spark2k06/XTSD/README.md

XTSD (Low Profile)  ReadMe
--------------------------

8-bit ISA IDE interface with IDE female connector for SD Adapter + Boot ROM (two separate functions that can be used individually).

Credit:
-------

Design uses schematic from Monotech-PC, which, in turn, is based on the schematic from XT-IDE Rev2 and Glitchworks:

https://github.com/monotech/XT-IDE-Deluxe
http://www.github.com/glitchwrks/xt_ide

XT-IDE Universal BIOS\
www.xtideuniversalbios.org  
www.xtideuniversalbios.org/binaries  

Use the latest working binary that includes XTIDECFG.COM (config utility), ide_xt.bin (8086/8088), ide_xtp.bin (80186/V20/V30 and up).

More info:

https://www.tindie.com/products/spark2k06/micro-xtcf-isa-8-bits-very-low-profile/
