spark2k06/XTSD/Schema.pdf

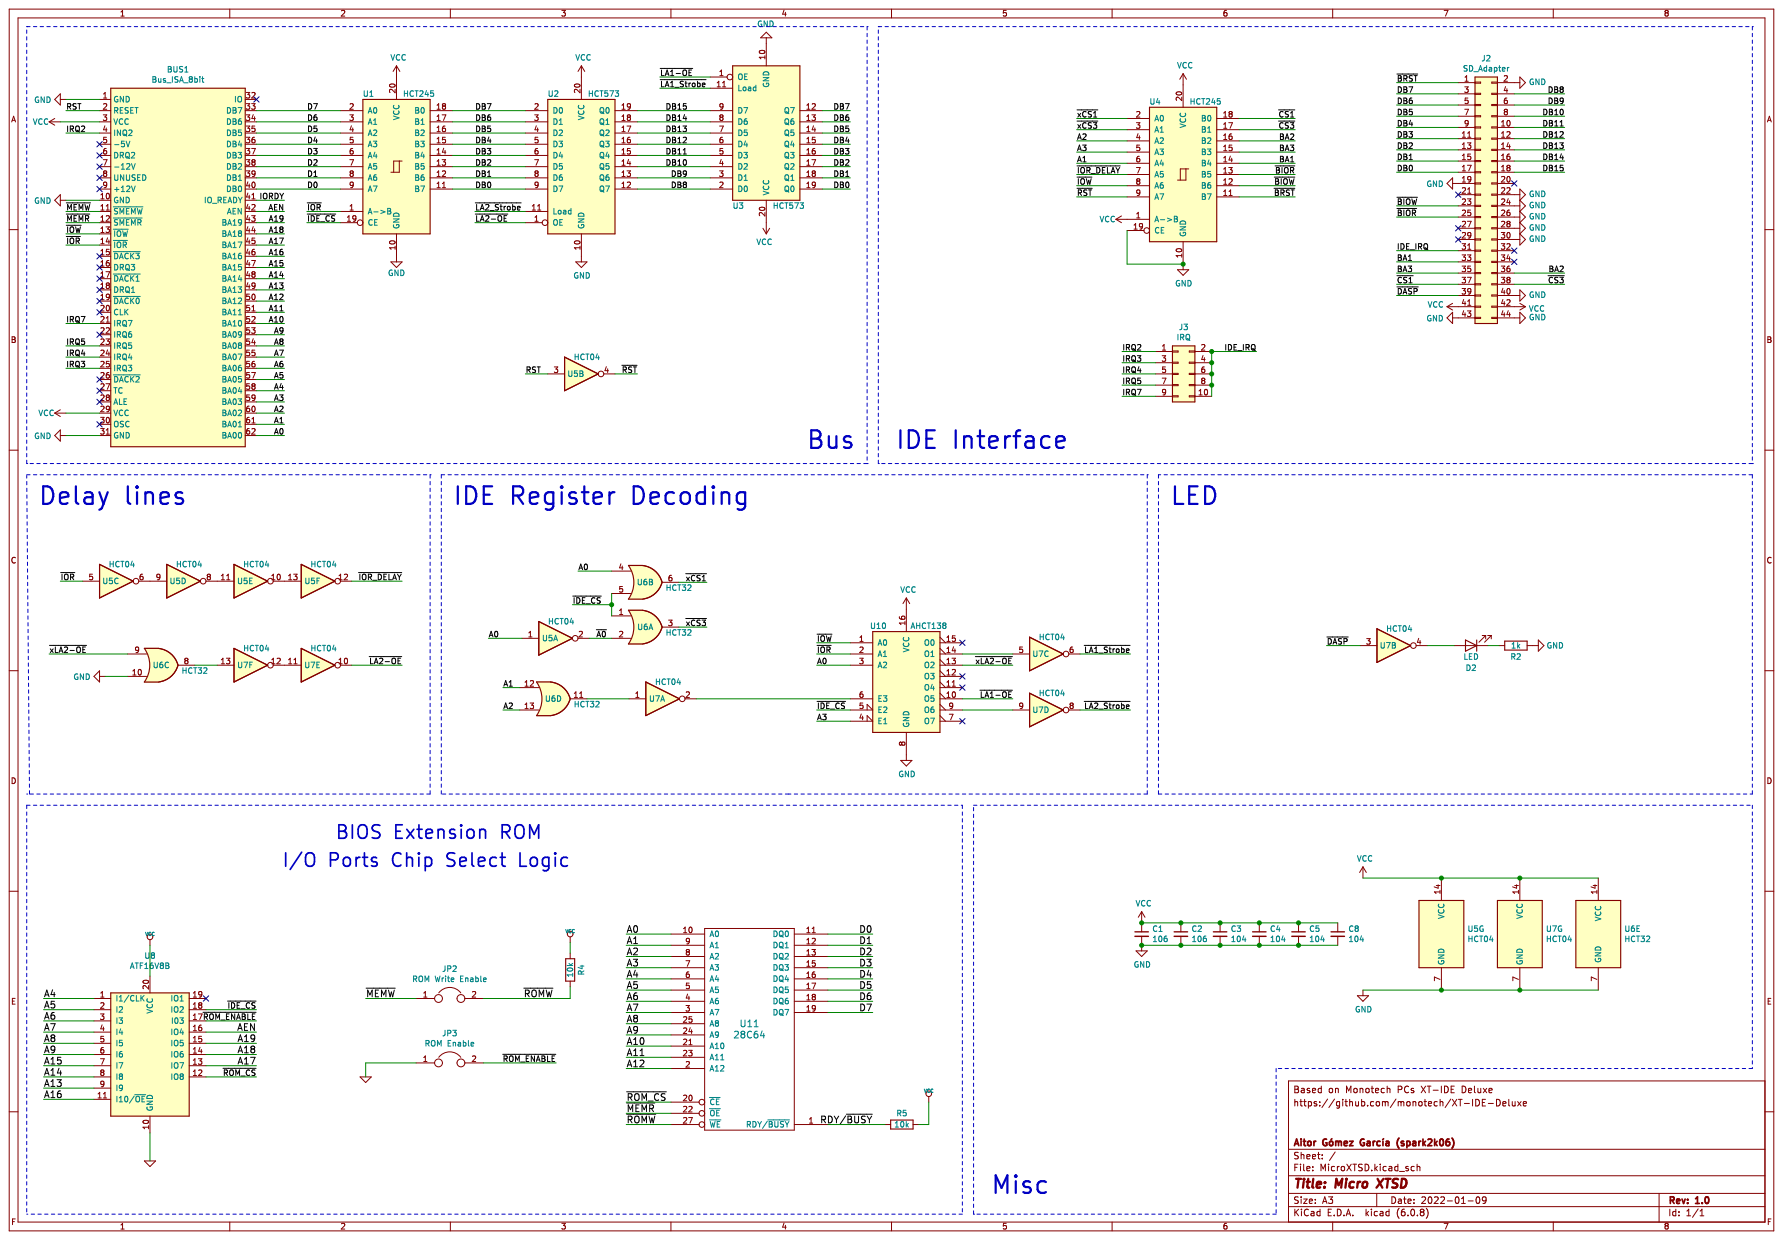
[picture p1: page 1]
