spark2k06/XTSD/kicad/MicroXTSD.kicad_sch

## KiCad design kicad/MicroXTSD.kicad_sch (2023-02-01)

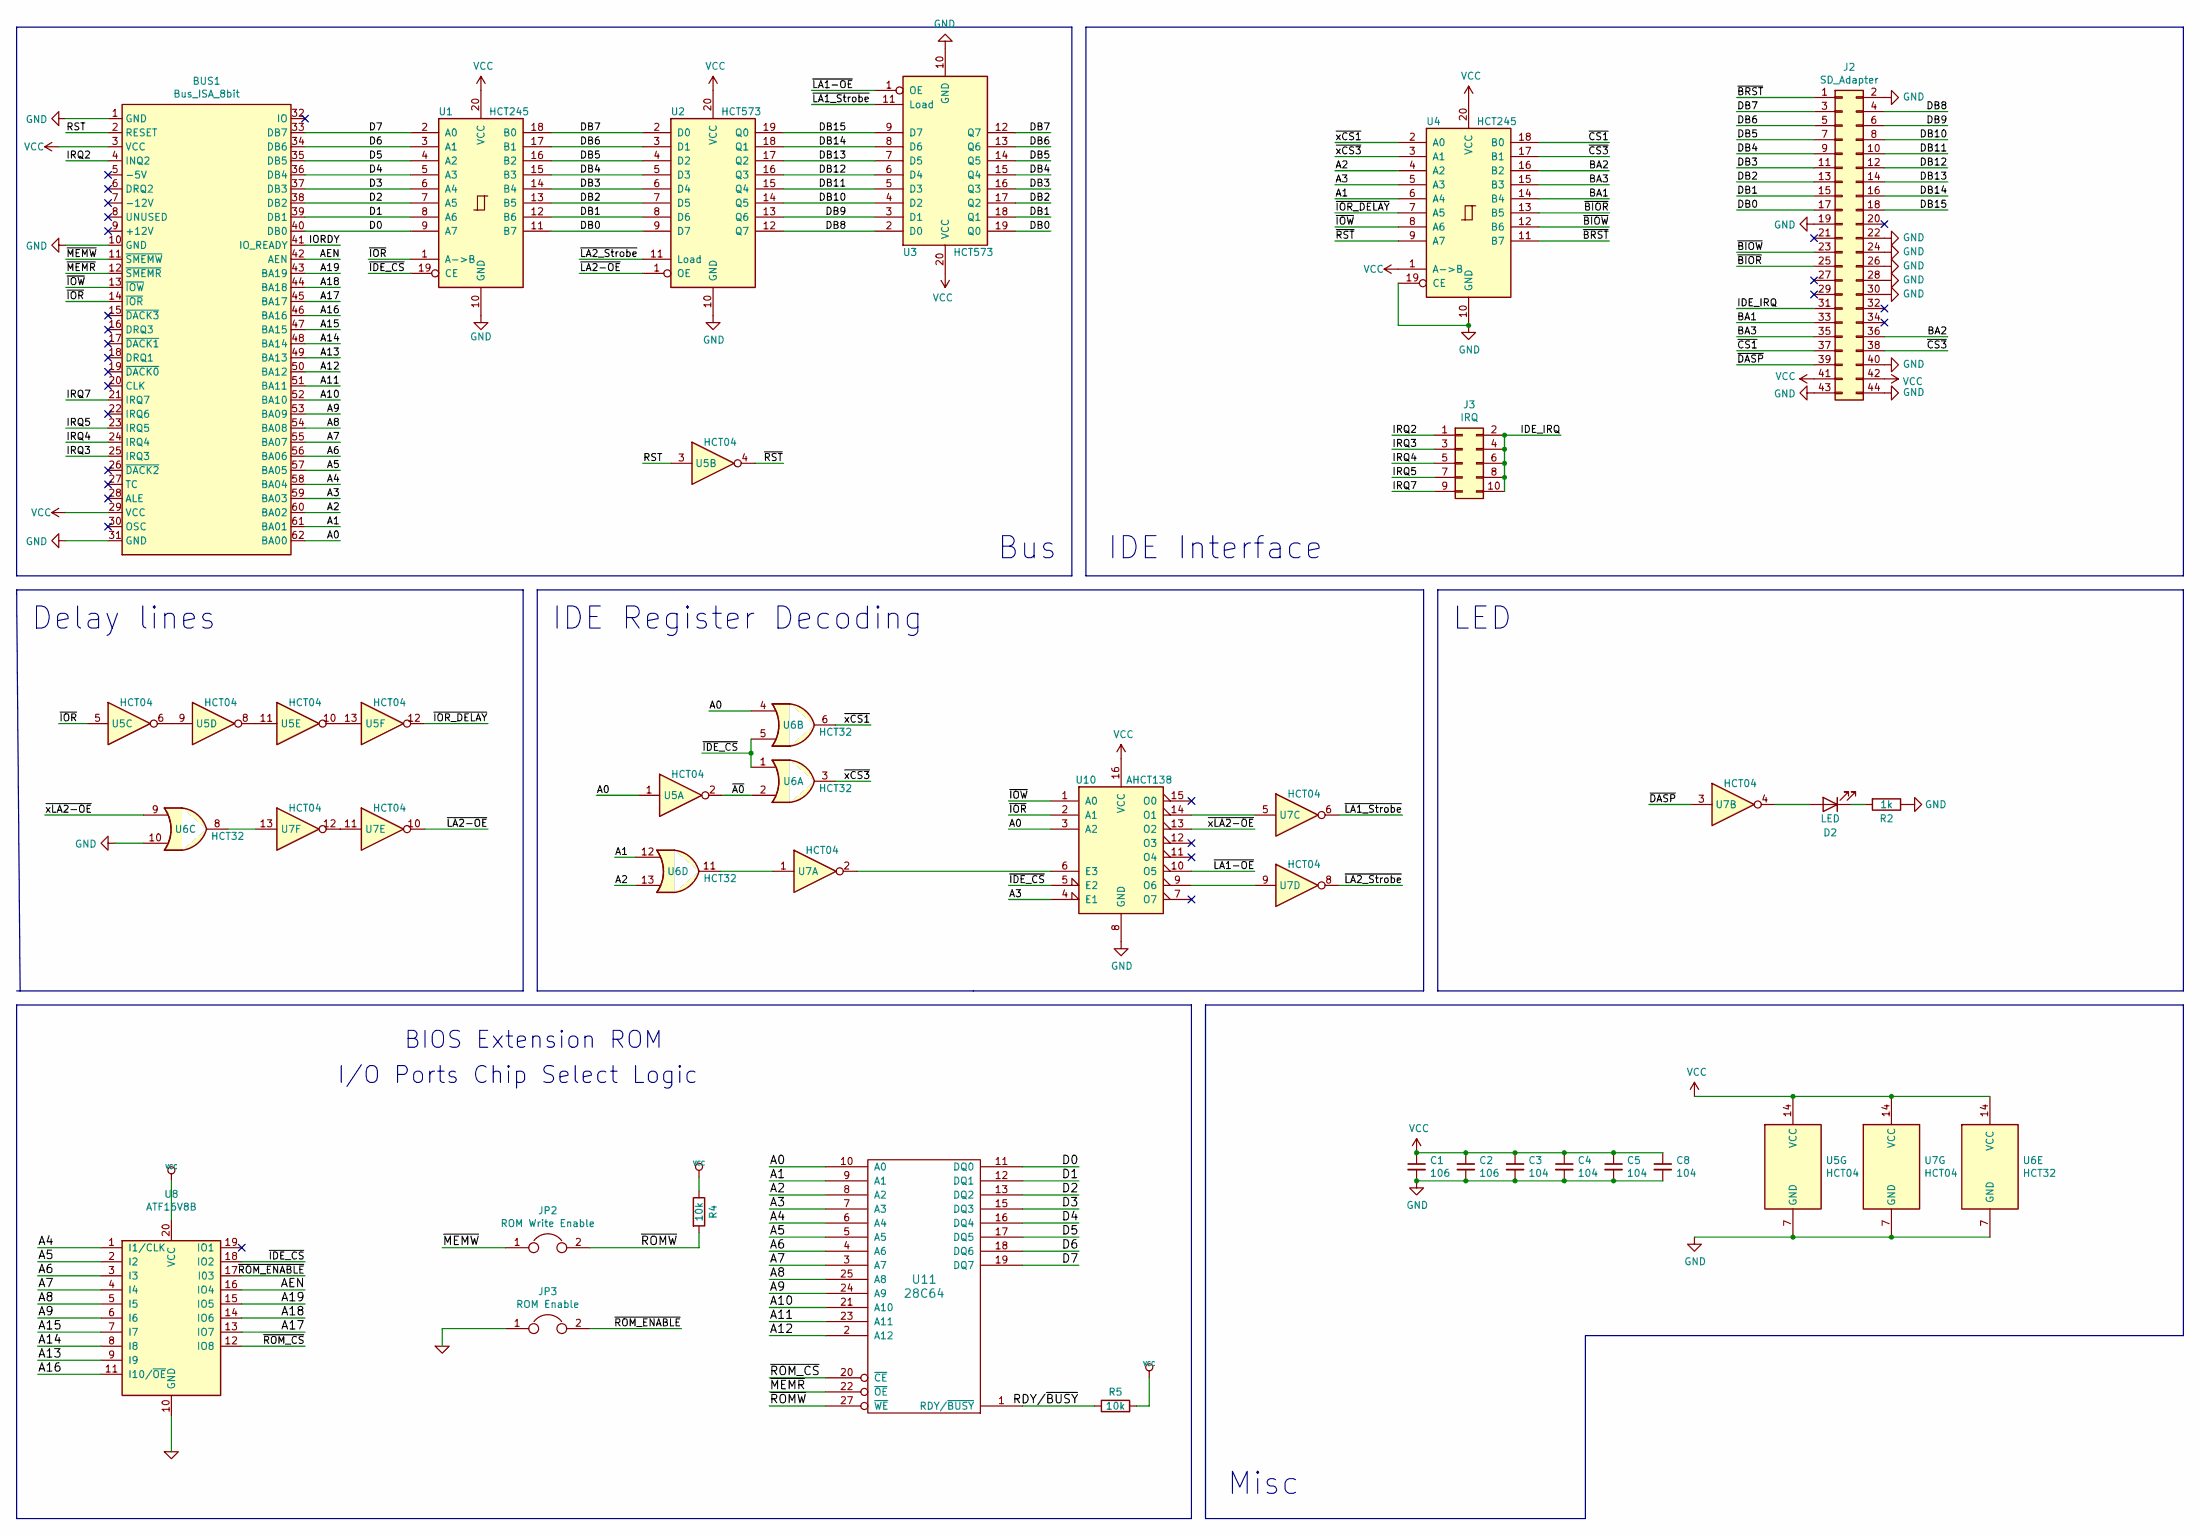
[picture p2: schematic MicroXTSD.kicad_sch]

Parts:
BUS1: Bus_ISA_8bit; ISA-8BIT-XT-IDE
C1, C2: 106; C_0805_2012Metric
C3, C4, C5, C8: 104; C_0805_2012Metric
D2: LED; PinHeader_1x02_P2.54mm_Horizontal
J2: SD_Adapter; PinSocket_2x22_P2.00mm_Horizontal
J3: IRQ; PinHeader_2x05_P2.54mm_Vertical
JP2: ROM Write Enable; PinHeader_1x02_P2.54mm_Vertical
JP3: ROM Enable; PinHeader_1x02_P2.54mm_Vertical
R2: 1k; R_0805_2012Metric
R4, R5: 10k; R_0805_2012Metric
U1, U4: HCT245; TSSOP-20_4.4x6.5mm_P0.65mm
U2, U3: HCT573; SO-20_5.3x12.6mm_P1.27mm
U5, U7: HCT04; SOIC-14_3.9x8.7mm_P1.27mm
U6: HCT32; SOIC-14_3.9x8.7mm_P1.27mm
U8: ATF16V8B; DIP-20_W7.62mm_Socket
U10: AHCT138; SOIC-16_3.9x9.9mm_P1.27mm
U11: 28C64; DIP-28_W15.24mm_Socket

Connections:
A0: BUS1.62 (BA00), U5.1, U6.4, U10.3 (A2), U11.10 (A0)
A1: BUS1.61 (BA01), U4.6 (A4), U6.12, U11.9 (A1)
A2: BUS1.60 (BA02), U4.4 (A2), U6.13, U11.8 (A2)
A3: BUS1.59 (BA03), U4.5 (A3), U10.4 (E1), U11.7 (A3)
A4: BUS1.58 (BA04), U8.1 (I1/CLK), U11.6 (A4)
A5: BUS1.57 (BA05), U8.2 (I2), U11.5 (A5)
A6: BUS1.56 (BA06), U8.3 (I3), U11.4 (A6)
A7: BUS1.55 (BA07), U8.4 (I4), U11.3 (A7)
A8: BUS1.54 (BA08), U8.5 (I5), U11.25 (A8)
A9: BUS1.53 (BA09), U8.6 (I6), U11.24 (A9)
A10: BUS1.52 (BA10), U11.21 (A10)
A11: BUS1.51 (BA11), U11.23 (A11)
A12: BUS1.50 (BA12), U11.2 (A12)
A13: BUS1.49 (BA13), U8.9 (I9)
A14: BUS1.48 (BA14), U8.8 (I8)
A15: BUS1.47 (BA15), U8.7 (I7)
A16: BUS1.46 (BA16), U8.11 (I10/~OE)
A17: BUS1.45 (BA17), U8.13 (IO7)
A18: BUS1.44 (BA18), U8.14 (IO6)
A19: BUS1.43 (BA19), U8.15 (IO5)
AEN: BUS1.42 (AEN), U8.16 (IO4)
BA1: J2.33, U4.14 (B4)
BA2: J2.36, U4.16 (B2)
BA3: J2.35, U4.15 (B3)
D0: BUS1.40 (DB0), U1.9 (A7), U11.11 (DQ0)
D1: BUS1.39 (DB1), U1.8 (A6), U11.12 (DQ1)
D2: BUS1.38 (DB2), U1.7 (A5), U11.13 (DQ2)
D3: BUS1.37 (DB3), U1.6 (A4), U11.15 (DQ3)
D4: BUS1.36 (DB4), U1.5 (A3), U11.16 (DQ4)
D5: BUS1.35 (DB5), U1.4 (A2), U11.17 (DQ5)
D6: BUS1.34 (DB6), U1.3 (A1), U11.18 (DQ6)
D7: BUS1.33 (DB7), U1.2 (A0), U11.19 (DQ7)
DB0: J2.17, U1.11 (B7), U2.9 (D7), U3.19 (Q0)
DB1: J2.15, U1.12 (B6), U2.8 (D6), U3.18 (Q1)
DB2: J2.13, U1.13 (B5), U2.7 (D5), U3.17 (Q2)
DB3: J2.11, U1.14 (B4), U2.6 (D4), U3.16 (Q3)
DB4: J2.9, U1.15 (B3), U2.5 (D3), U3.15 (Q4)
DB5: J2.7, U1.16 (B2), U2.4 (D2), U3.14 (Q5)
DB6: J2.5, U1.17 (B1), U2.3 (D1), U3.13 (Q6)
DB7: J2.3, U1.18 (B0), U2.2 (D0), U3.12 (Q7)
DB8: J2.4, U2.12 (Q7), U3.2 (D0)
DB9: J2.6, U2.13 (Q6), U3.3 (D1)
DB10: J2.8, U2.14 (Q5), U3.4 (D2)
DB11: J2.10, U2.15 (Q4), U3.5 (D3)
DB12: J2.12, U2.16 (Q3), U3.6 (D4)
DB13: J2.14, U2.17 (Q2), U3.7 (D5)
DB14: J2.16, U2.18 (Q1), U3.8 (D6)
DB15: J2.18, U2.19 (Q0), U3.9 (D7)
GND: BUS1.1 (GND), BUS1.10 (GND), BUS1.31 (GND), C1.2, C2.2, C3.2, C4.2, C5.2, C8.2, J2.2, J2.19, J2.22, J2.24, J2.26, J2.28, J2.30, J2.40, J2.43, J2.44, JP3.1, R2.1, U1.10 (GND), U2.10 (GND), U3.10 (GND), U4.10 (GND), U4.19 (CE), U5.7 (GND), U6.7 (GND), U7.7 (GND), U8.10 (GND), U10.8 (GND)
IDE_IRQ: J2.31, J3.2, J3.4, J3.6, J3.8, J3.10
IORDY: BUS1.41 (IO_READY)
IRQ2: BUS1.4 (INQ2), J3.1
IRQ3: BUS1.25 (IRQ3), J3.3
IRQ4: BUS1.24 (IRQ4), J3.5
IRQ5: BUS1.23 (IRQ5), J3.7
IRQ7: BUS1.21 (IRQ7), J3.9
unnamed: D2.1 (K), R2.2
unnamed: D2.2 (A), U7.4
unnamed: U5.6, U5.9
unnamed: U5.10, U5.13
unnamed: U5.8, U5.11
unnamed: U6.8, U7.13
unnamed: U6.11, U7.1
unnamed: U7.11, U7.12
unnamed: U7.2, U10.6 (E3)
unnamed: U7.9, U10.9 (O6)
unnamed: U7.5, U10.14 (O1)
RDY/~BUSY: R5.1, U11.1 (RDY/~BUSY)
RST: BUS1.2 (RESET), U5.3
VCC: BUS1.3 (VCC), BUS1.29 (VCC), C1.1, C2.1, C3.1, C4.1, C5.1, C8.1, J2.41, J2.42, R4.1, R5.2, U1.20 (VCC), U2.20 (VCC), U3.20 (VCC), U4.1 (A->B), U4.20 (VCC), U5.14 (VCC), U6.14 (VCC), U7.14 (VCC), U8.20 (VCC), U10.16 (VCC)
~A0: U5.2, U6.2
~BIOR: J2.25, U4.13 (B5)
~BIOW: J2.23, U4.12 (B6)
~BRST: J2.1, U4.11 (B7)
~CS1: J2.37, U4.18 (B0)
~CS3: J2.38, U4.17 (B1)
~DASP: J2.39, U7.3
~IDE_CS: U1.19 (CE), U6.1, U6.5, U8.18 (IO2), U10.5 (E2)
~IOR_DELAY: U4.7 (A5), U5.12
~IOR: BUS1.14 (~IOR), U1.1 (A->B), U5.5, U10.2 (A1)
~IOW: BUS1.13 (~IOW), U4.8 (A6), U10.1 (A0)
~LA1-OE: U3.1 (OE), U10.10 (O5)
~LA1_Strobe: U3.11 (Load), U7.6
~LA2-OE: U2.1 (OE), U7.10
~LA2_Strobe: U2.11 (Load), U7.8
~MEMR: BUS1.12 (~SMEMR), U11.22 (~OE)
~MEMW: BUS1.11 (~SMEMW), JP2.1
~ROMW: JP2.2, R4.2, U11.27 (~WE)
~ROM_CS: U8.12 (IO8), U11.20 (~CE)
~ROM_ENABLE: JP3.2, U8.17 (I03)
~RST: U4.9 (A7), U5.4
~xCS1: U4.2 (A0), U6.6
~xCS3: U4.3 (A1), U6.3
~xLA2-OE: U6.9, U10.13 (O2)

Notes on the sheet:
Delay lines
IDE Interface
BIOS Extension ROM
LED
IDE Register Decoding
I/O Ports Chip Select Logic
Misc
Bus
