spark2k06/XTSD/(commit log)

2023-01-23 Schema: Kicad sources and PDF
    [MicroXTSD.csv, MicroXTSD.kicad_sch, MicroXTSD.sch]
2023-02-01 Revision 3
    [MicroXTSD.kicad_sch]
